azya52/STMP/(threads)

Thread 1 (2019-07-30):

[Offtopic] Это шикарно

vladkorotnev, 2019-07-30:
Очень рад, что кто-то довёл всё-таки мою идею до конца!
Большое спасибо!

vladkorotnev, 2019-07-30:
Как у получившегося модуля с потреблением, кстати? В своё время столкнулся, что при выключении калькулятора остаётся питание на картридже, хоть и чуть ниже (3.3 вместо 5) -- в итоге картридж не сбрасывался назад в автозапуск, жрал батарейку до кучи.

azya52, 2019-07-30:
Спасибо! Ваш проект сильно помог.
С потреблением не очень хорошо - около 5мА и при разряженных аккумуляторах приходится включать на горячую, иначе мк90 не хочет запускаться с такой нагрузкой. Вообще я изначально планировал развести отдельную плату и использовать STM32F4, там есть встроенный POR/PDR - можно было бы уходить в сброс при падении напряжения и проблемы бы не было, к тому же в этой серии есть дешевые контроллеры с 512кб флеша (все же 128 маловато), но что-то меня программирование игр для него отвлекло.

silensilen, 2020-02-13:
Спасибо за разработку!
Какой разъём/штекер Вы использовали для подключения к МК-90?

azya52, 2020-02-17:
silensilen, я использовал обычный штырьевой разъем, чуть рассверлив отверстия. Что-то штатно подходящее у меня найти так и не получилось.

silensilen, 2020-02-17:
> silensilen, я использовал обычный штырьевой разъем, чуть рассверлив отверстия. Что-то штатно подходящее у меня найти так и не получилось.

Да, я тоже, но не рассверливал, а перевернул  контакты на 90градусов и зафиксировал их клеем.

Closed 2023-05-01.

Thread 2 (2022-10-18):

Firmware STMP.hex

dk1spb, 2022-10-18:
Добрый день!
Заливаю прошивку - при подключении "A request for the USB device descriptor failed"
Пробую с другой прошивкой - всё норм, то есть, скорее всего, дело не в том что я неправильно прошиваю и не в устройстве.
Точно ли выложена рабочая прошивка?

azya52, 2023-04-29:
Здравствуйте!
Прошу прощения, только сейчас увидел и то наткнувшись на ваше сообщение на phantom.sannata.org, что-то github не присылает уведомление о новых issues :(
Не знаю, актуально ли еще, но проверил сейчас - залил hex выложенный здесь - нормально определяется как USB. Может проблема в разных ревизиях/версиях Bluepill, у вас классическая плата на STM32F103C8T6? Как вариант, можете прогнать этот тест https://mecrisp-stellaris-folkdoc.sourceforge.io/bluepill-diagnostics-v1.6.html, возможно удастся выявить отличия в наших платах.

azya52, 2023-05-01:
Все же была ошибка :( исправил.

Closed 2023-05-01.

Thread 3 (2025-02-15):

Windows не удается завершить форматирование

Bs0Dd, 2025-02-15:
Прикупил себе пару STM32F103C8T6 для сборки эмулятора. Микроконтроллеров не касался лет 5, но что-то да помню.

<a href="https://i.imgur.com/aj22Ohj.jpg">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</a>

Резисторы на R10 вроде нужного номинала, тестером замеряются как 1.5КОм.

<a href="https://i.imgur.com/TNgA92T.jpg">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</a>

Подключаю к ST-LINK V2 и шью STM32Cube, прошивка и верификация проходят

Причем, к слову, программа определяет в микроконтроллере не 64/128, а даже 256КБ FLASH.

<a href="https://i.imgur.com/CXqzl9U.jpg">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</a>

После прошивки отключаю его от программатора и подкидываю по USB. Определяется USB накопитель и система предлагает его отформатировать. Форматирую...

<a href="https://i.imgur.com/qJCz1oC.jpg">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</a>

и "Windows не удается завершить форматирование". Какие бы я не пробовал параметры, отформатировать не получается.

Более того, если переподключить STM после попытки форматирования, оно превращается в Unknown Device с кодом 43.

<a href="https://i.imgur.com/2Loqw1b.jpg">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</a>

Подключил модуль обратно к ST-LINK и при чтении папяти оказывается, что кусок прошивки постоянно затирается FFами (видимо поэтому она перестает работать).

<a href="https://i.imgur.com/le4FVnT.png">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</a>

Собственно, не могу понять причину этого явления. Делаю ли я что-то не так, какой-то баг в прошивке или может сами микроконтроллеры работают некорректно, т.к. ситуация проявляется на обоих контроллерах.
