azya52/STMP/STMP/Inc/main.h

#define FLASH_START_ADDR	0x08000000
#define FLASH_FIRM_SIZE		0x00004400					//17kB for firmware
#define FLASH_FLASH_SIZE	0x00020000					//undocumented 128kB flash
#define FLASH_MSD_SIZE		(FLASH_FLASH_SIZE-FLASH_FIRM_SIZE)	//Mass storage size
#define FLASH_MSD_START_ADDR	(FLASH_START_ADDR + FLASH_FIRM_SIZE)	//USB MSD start address
#define PORT_CLK GPIOB
#define PIN_CLK GPIO_PIN_7
#define PIN_CLK_NUM 7
#define PORT_DATA GPIOB
#define PIN_DATA GPIO_PIN_8
#define PIN_DATA_NUM 8
#define PORT_SELECT GPIOB
#define PIN_SELECT GPIO_PIN_9
#define PIN_SELECT_NUM 9
#define PORT_LED GPIOC
#define PIN_LED GPIO_PIN_13
#define PIN_LED_NUM 13
