azya52/STMP/(commit log)

2019-06-07 change resistors nominal
2022-09-16 deep sleep with mk off; speed up; fix folder bug
    [main.c, main.h]
